Lucaszyf/lx200-smart-front-panel/hardware/pcb/LX200 SMART FRONT PANEL-WITH WI-FI & BLUETOOTH_V1.0-260811-4层.dxf

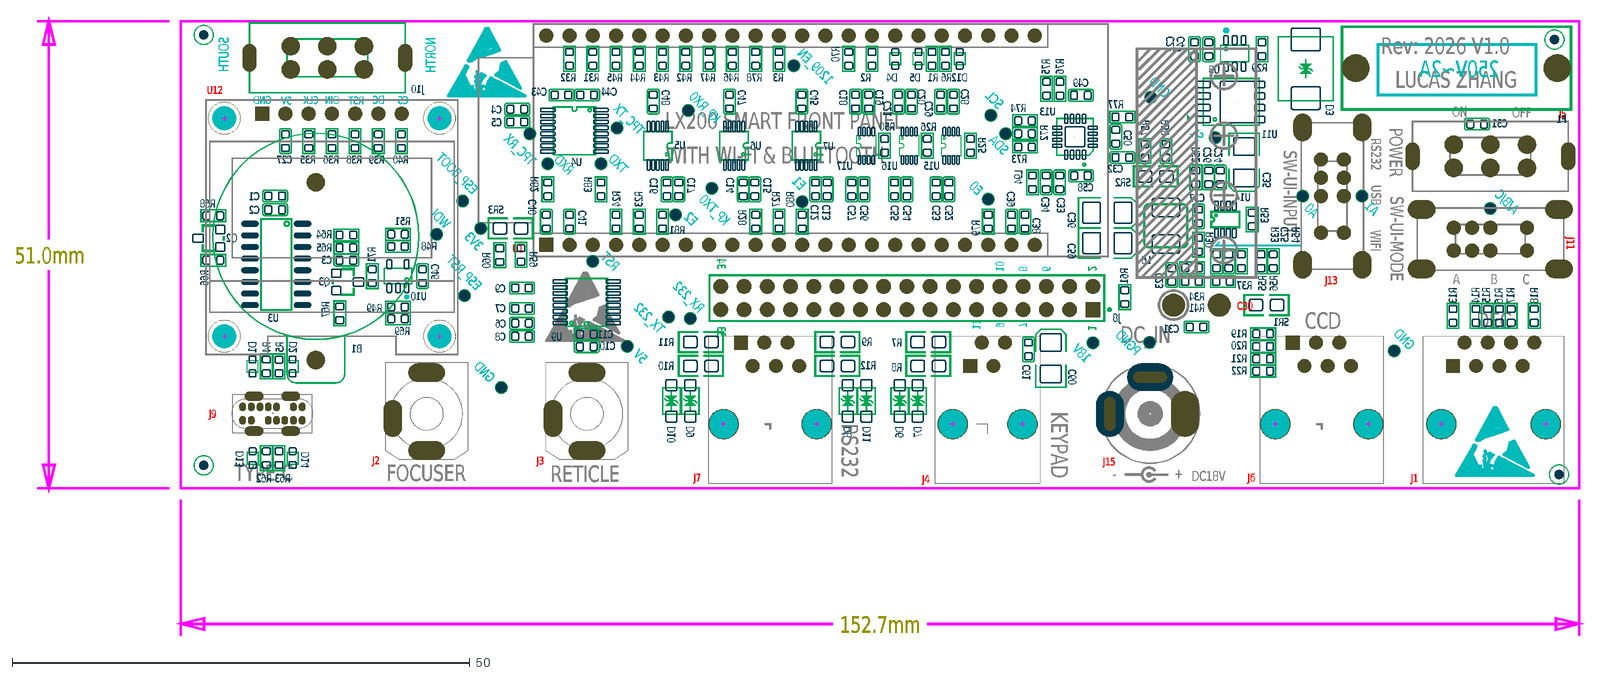
[picture p3: CAD file, 2026-10-14]
hardware/pcb/LX200 SMART FRONT PANEL-WITH WI-FI & BLUETOOTH_V1.0-260811-4层.dxf
152.7mm
51.0mm
-
+
FOCUSER
RETICLE
TYPE-C
RS232
KEYPAD
DC_IN
CCD
DEC
USB
WIFI
OFF
ON
A
B
C
ESP_RST
ESP_BOOT
A0
A1
A/B/C
5V
18V
3V3
PGND
GND
S1
SDA
SCL
NORTH
SOUTH
RXD
TXD
1209_EN
LX200 SMART FRONT PANEL
WITH WI-FI & BLUETOOTH
Rev: 2026 V1.0
LUCAS ZHANG
SW-UI-INPUT
SW-UI-MODE
POWER
250V~2A
DC18V
DC
CS
RST
DIN
CLK
KP_RX0
KP_TX0
E2
E1
E0
RX_232
TX_232
WDI
TPC_RX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
