Lucaszyf/lx200-smart-front-panel/assets/schematic-overview.pdf

D

6 | 5 | 4 | 3 | 2 | 1

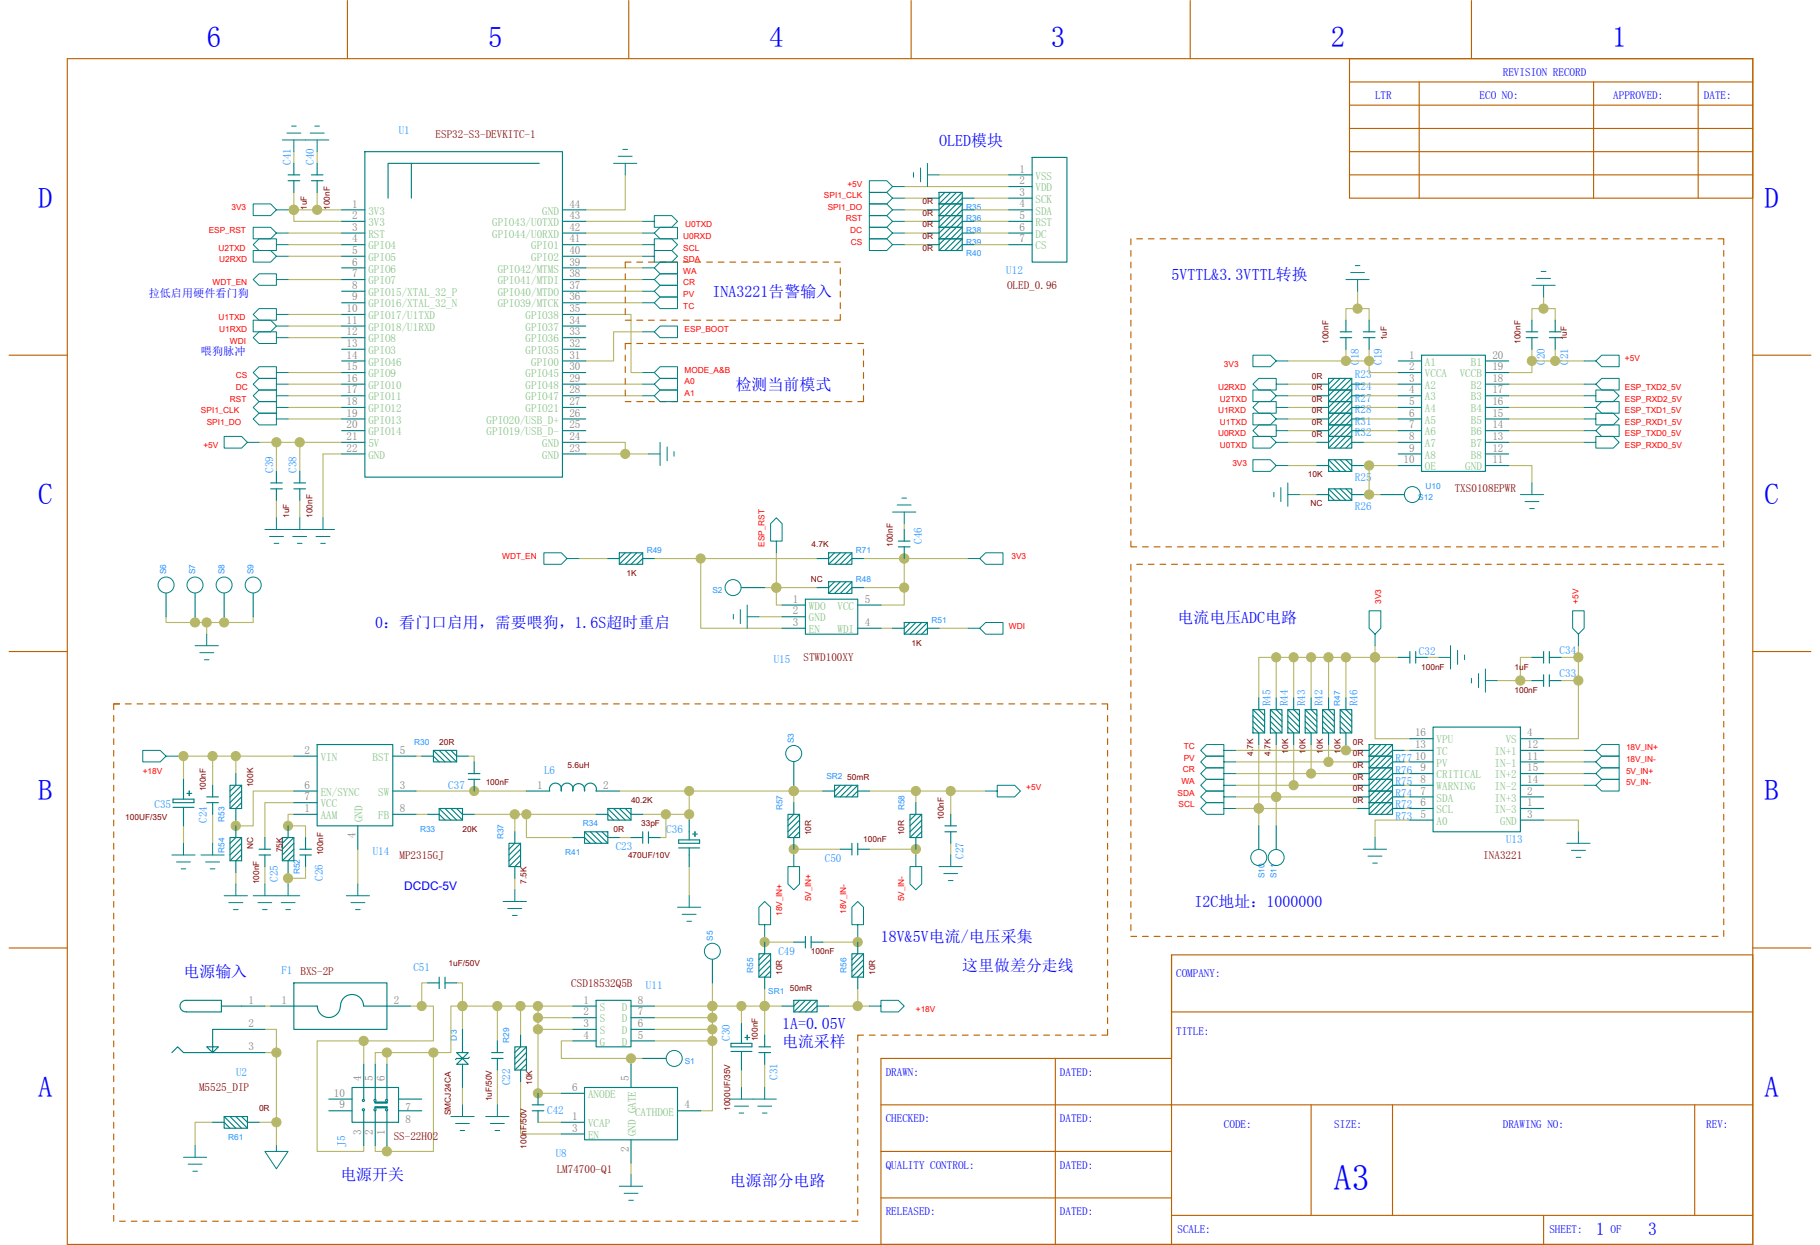
[picture p4: page 1]

CHECKED: | DATED: | CODE: | SIZE: A3 | DRAWING NO: | REV:

QUALITY CONTROL: | DATED:

RELEASED: | DATED:

SCALE: | SHEET: OF

D

6

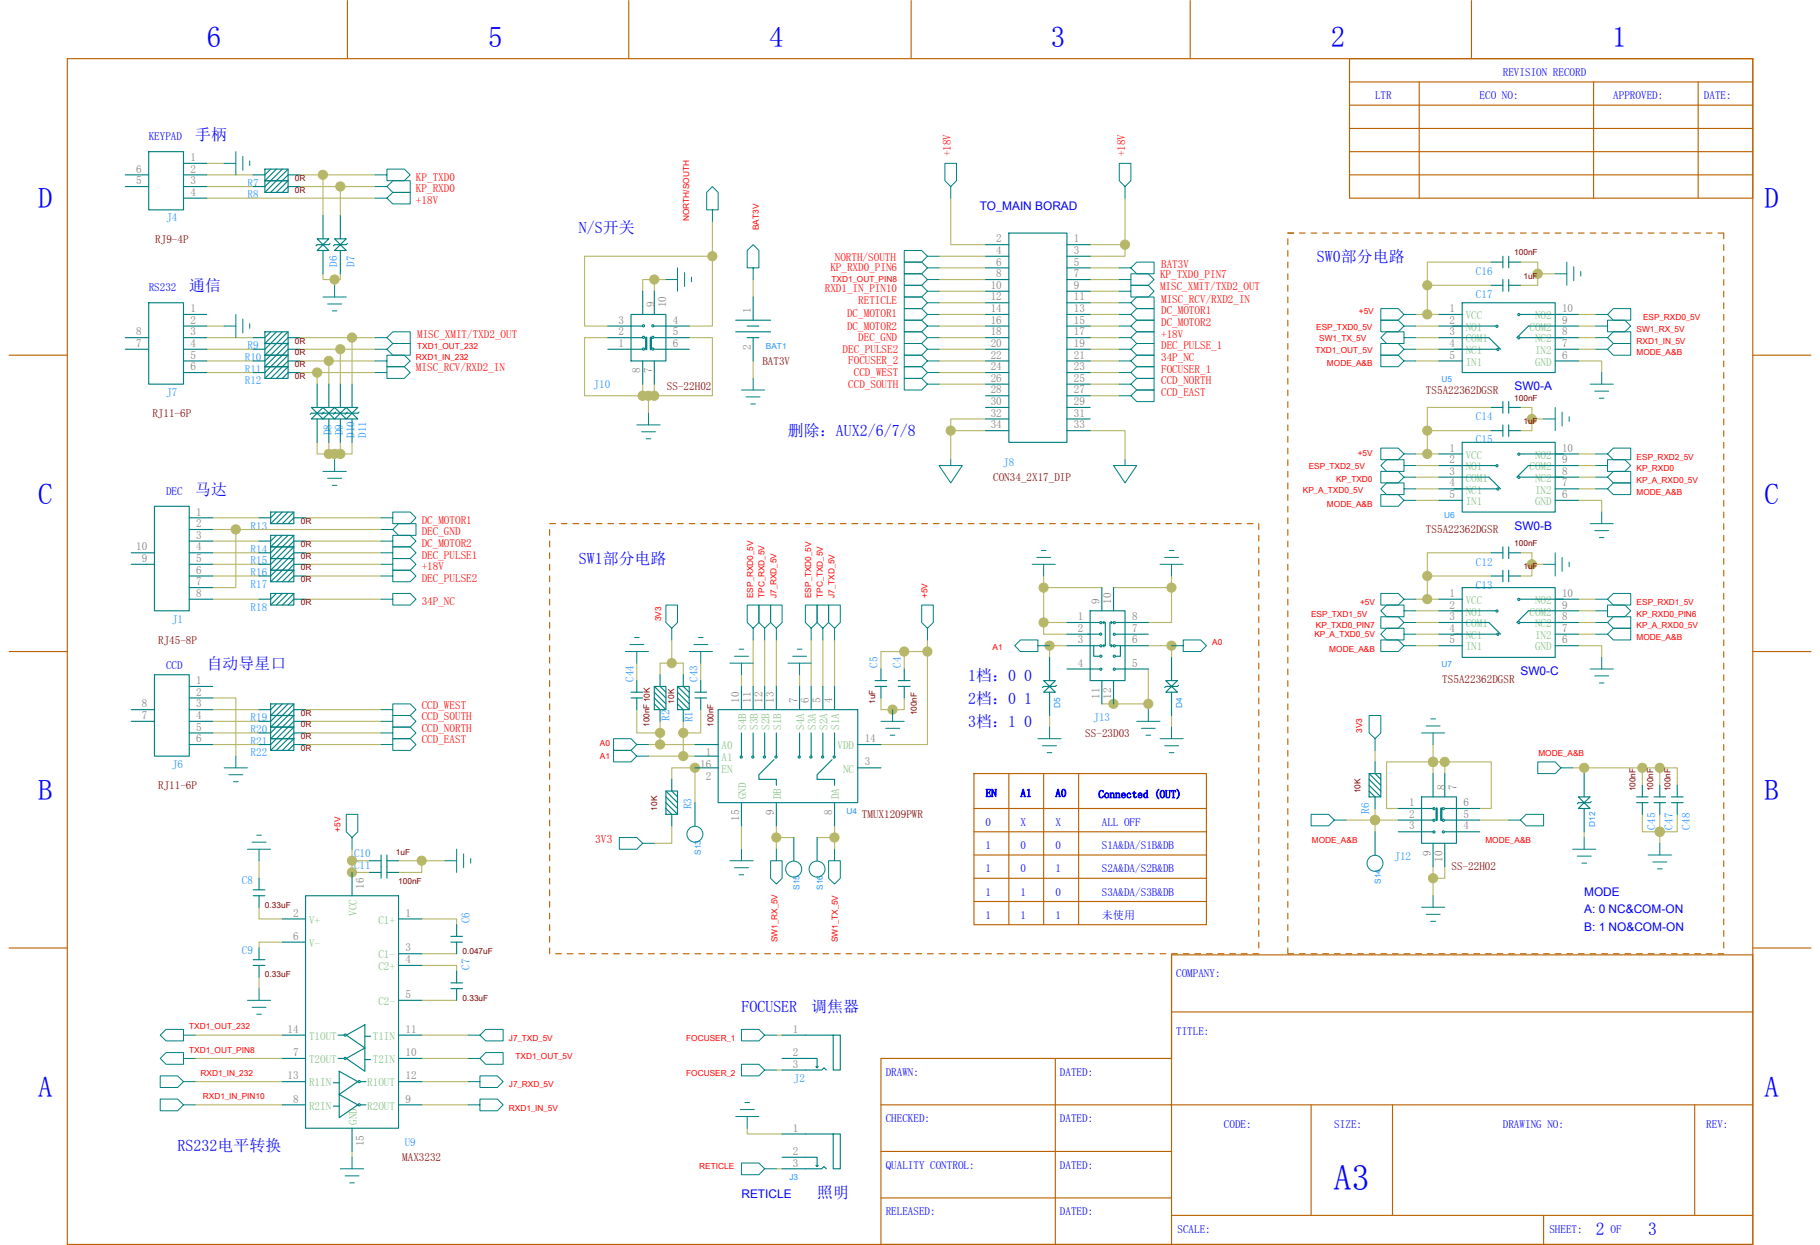
[picture p5: page 2]

D

6 | 5 | 4 | 3 | 2 | 1

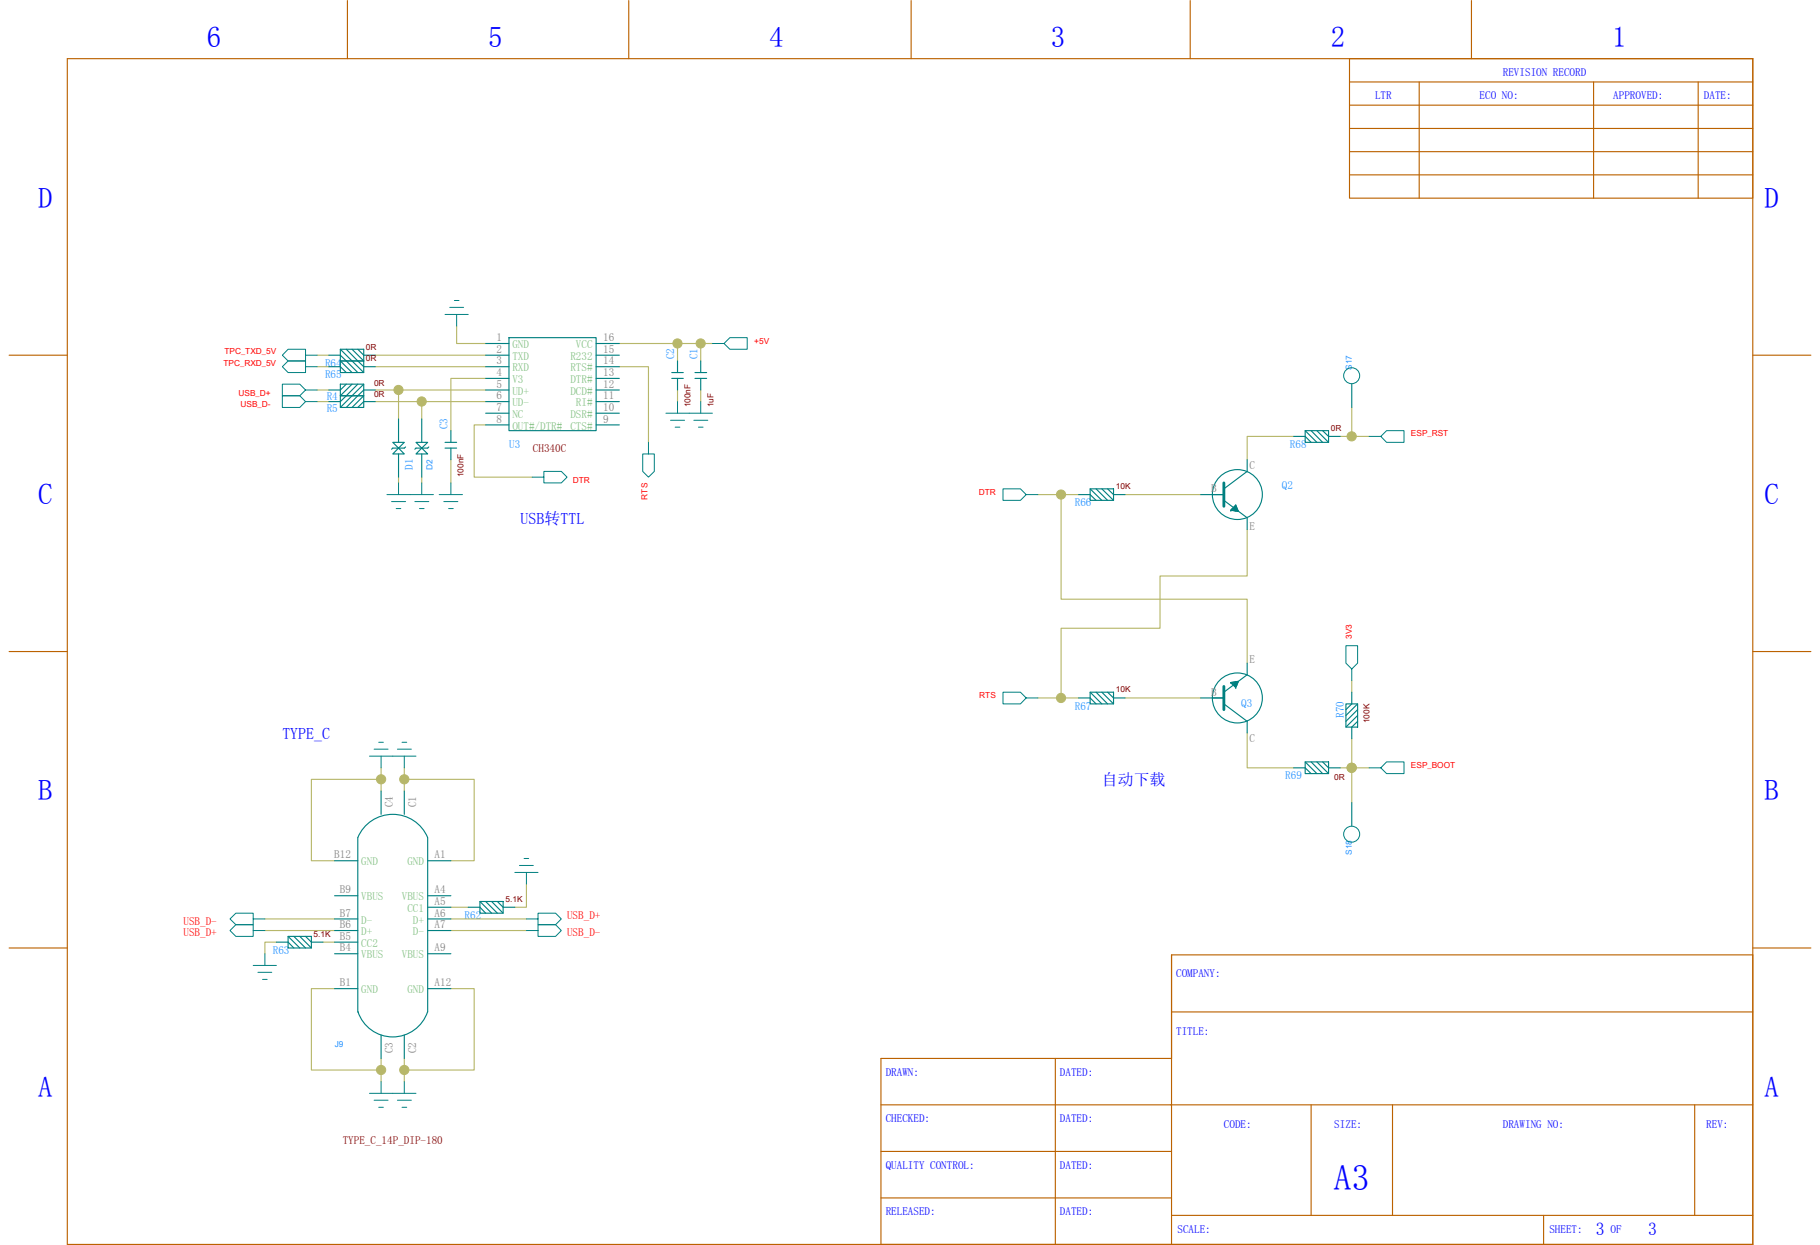
[picture p6: page 3]
