Lucaszyf/lx200-smart-front-panel/hardware/pcb/LX200 SMART FRONT PANEL-WITH WI-FI & BLUETOOTH_V1.0-260810-4层.pdf

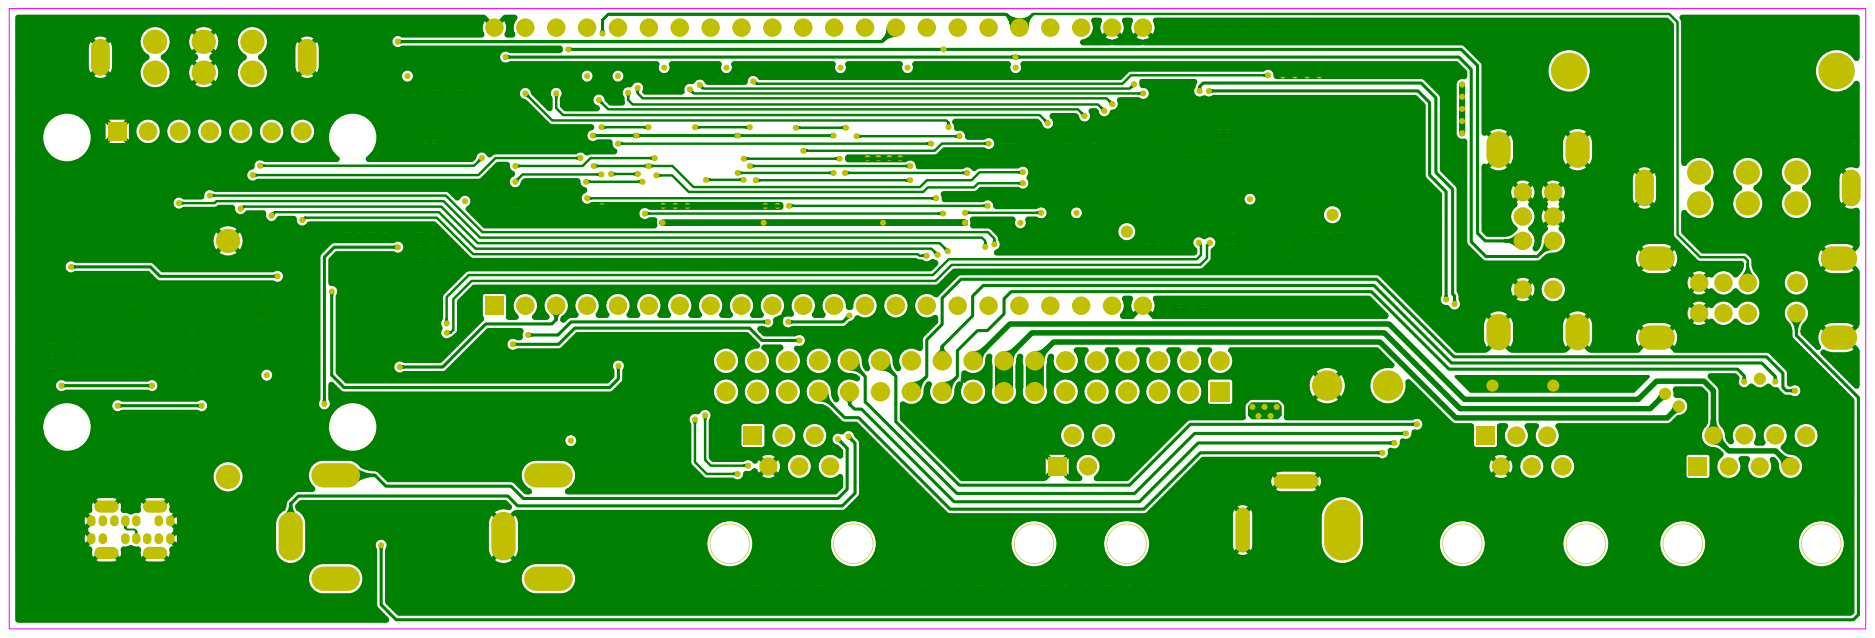
[picture p7: page 1]
U1 U¹x1; U¹x2; U¹x3; U¹x4; U¹x5; U¹x6; U¹x7; U¹x8; U¹x9; U¹x10; U¹x11; U¹x12; U¹x13; U¹x14; U¹x15; U¹x16; U¹x17; U¹x18; U¹x19; U¹x20; U¹x21; J9J9xA¹ J9xA⁴ J9xA⁵ J9xA⁶ J9xA⁷; J9xA⁹ J9xA¹² J9xB¹² J9xB⁹; J9xB⁷ J9xB⁶ J9xB⁵ J9xB⁴ J9xB¹ J9xC¹; J9xC² J9xC⁴; J9xC³; C30 C³⁰x2; C³⁰x1; B1B¹x1 B¹x2

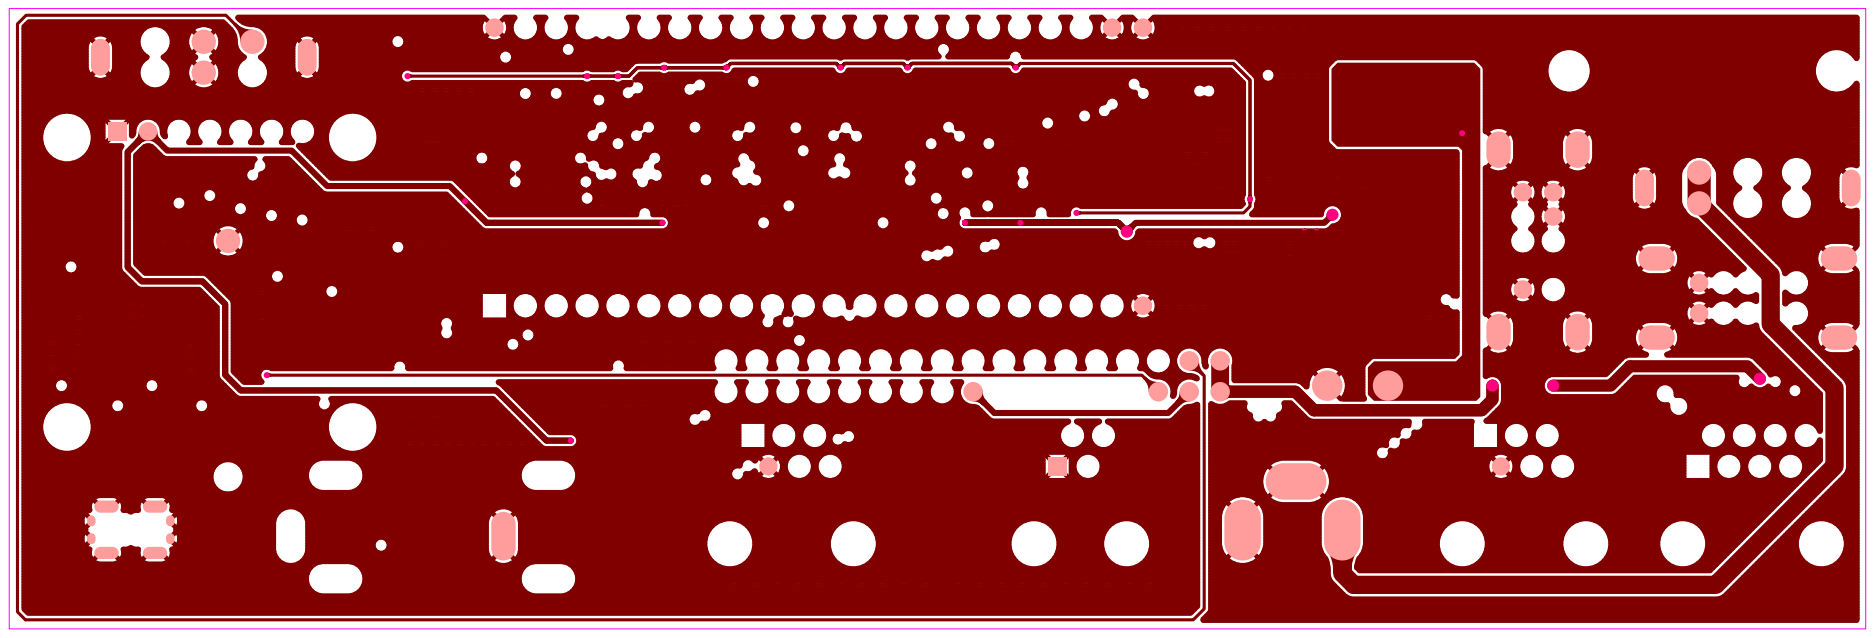
[picture p8: page 2]
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

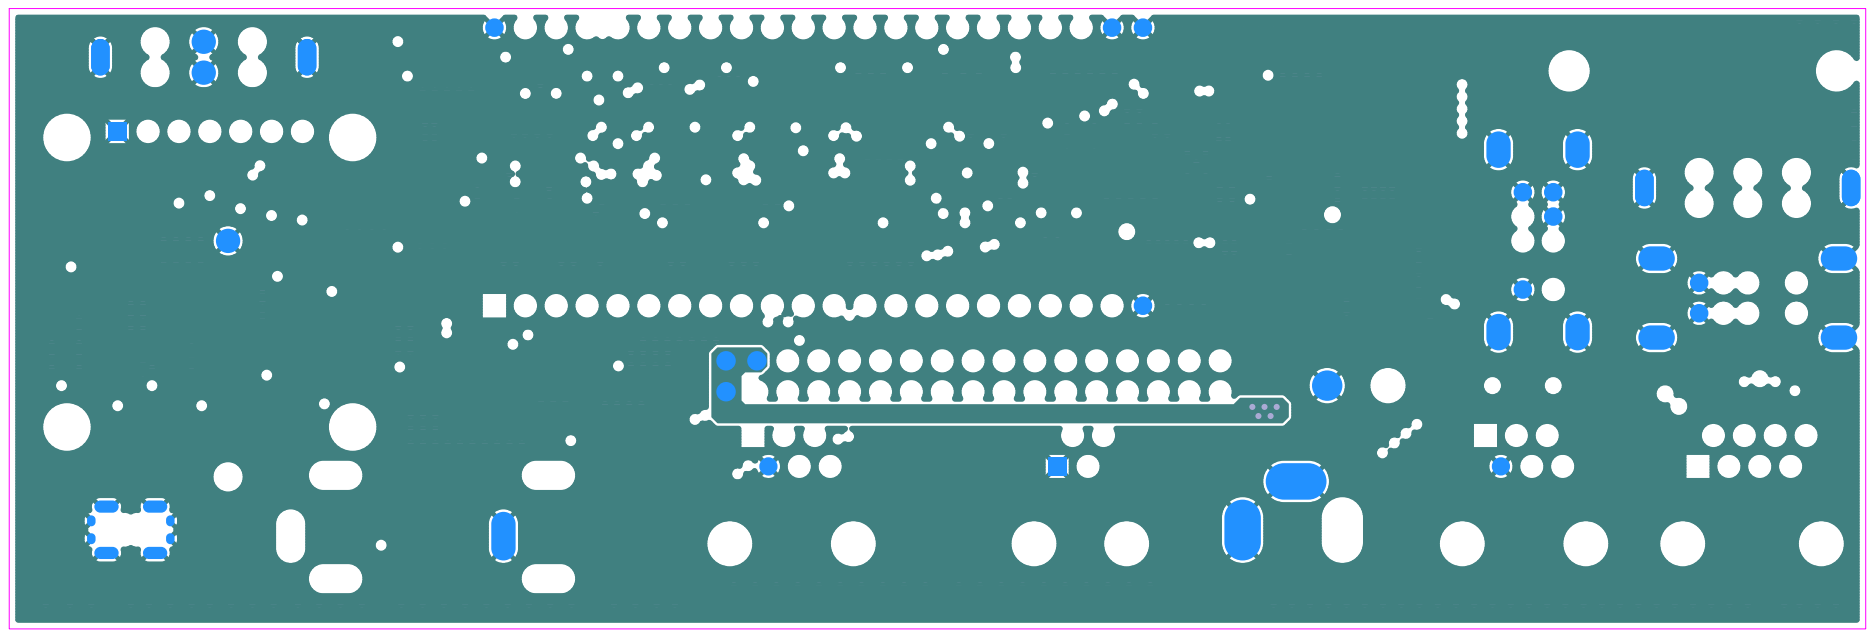
[picture p9: page 3]
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

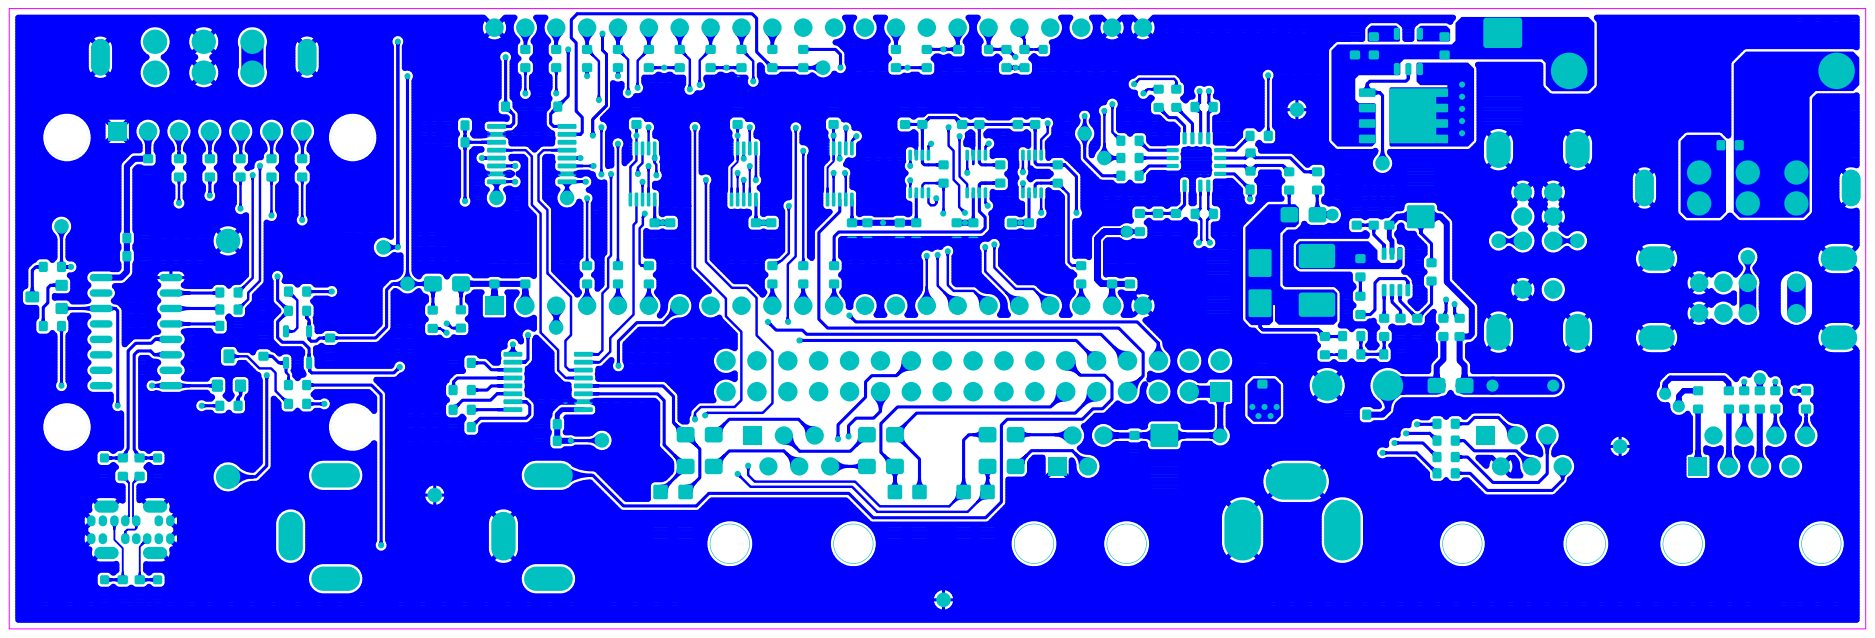
[picture p10: page 4]

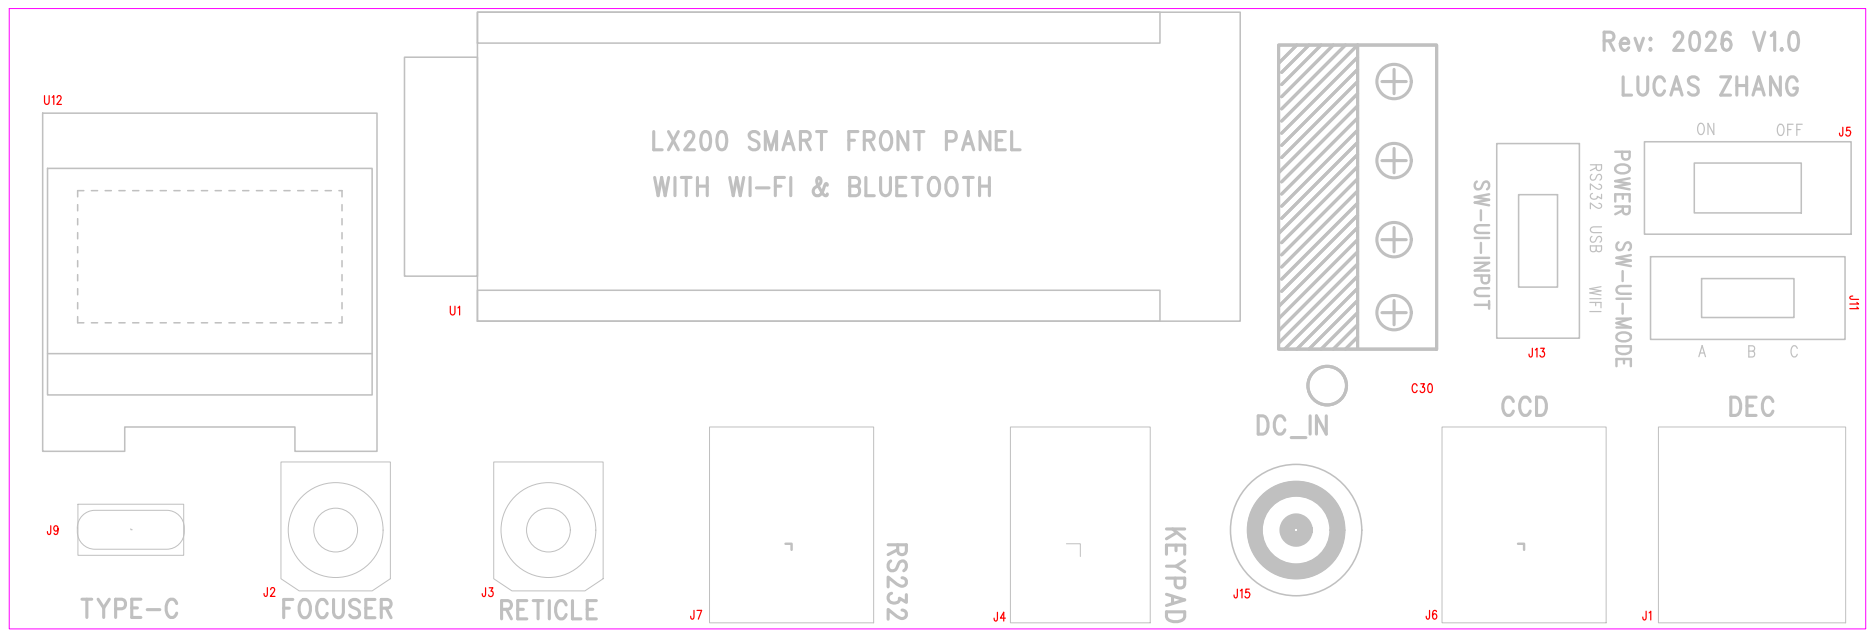
[picture p11: page 5]

LX200 SMART FRONT PANEL
WITH WI-FI & BLUETOOTH

SW-UI-MODE POWER

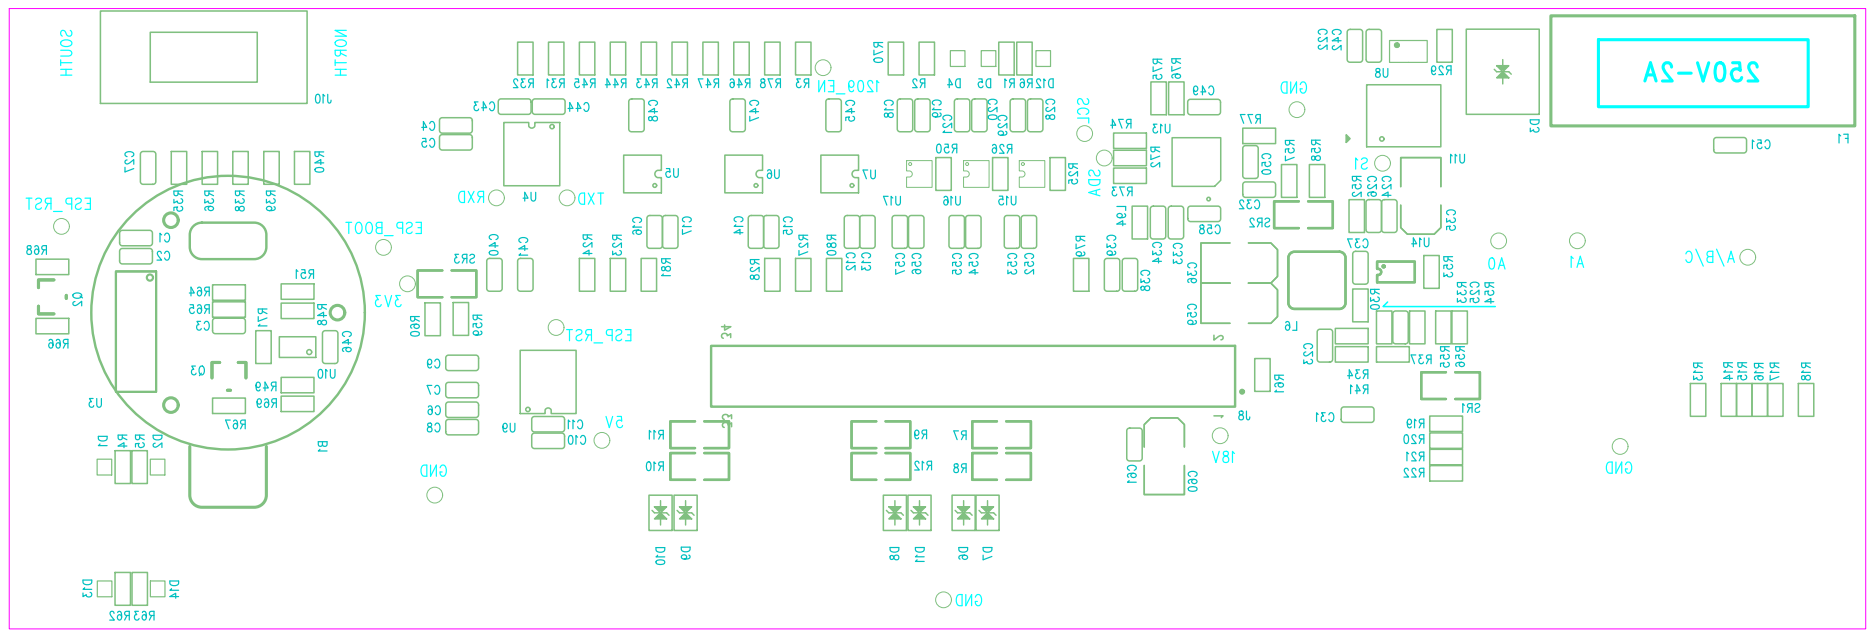
[picture p12: page 6]

J10J10x1 | J10x2 | J10x3 J10x6 | J10x5 | J10x4 J10x79 | J10x810x10
C30 C³⁰x2 | C³⁰x1

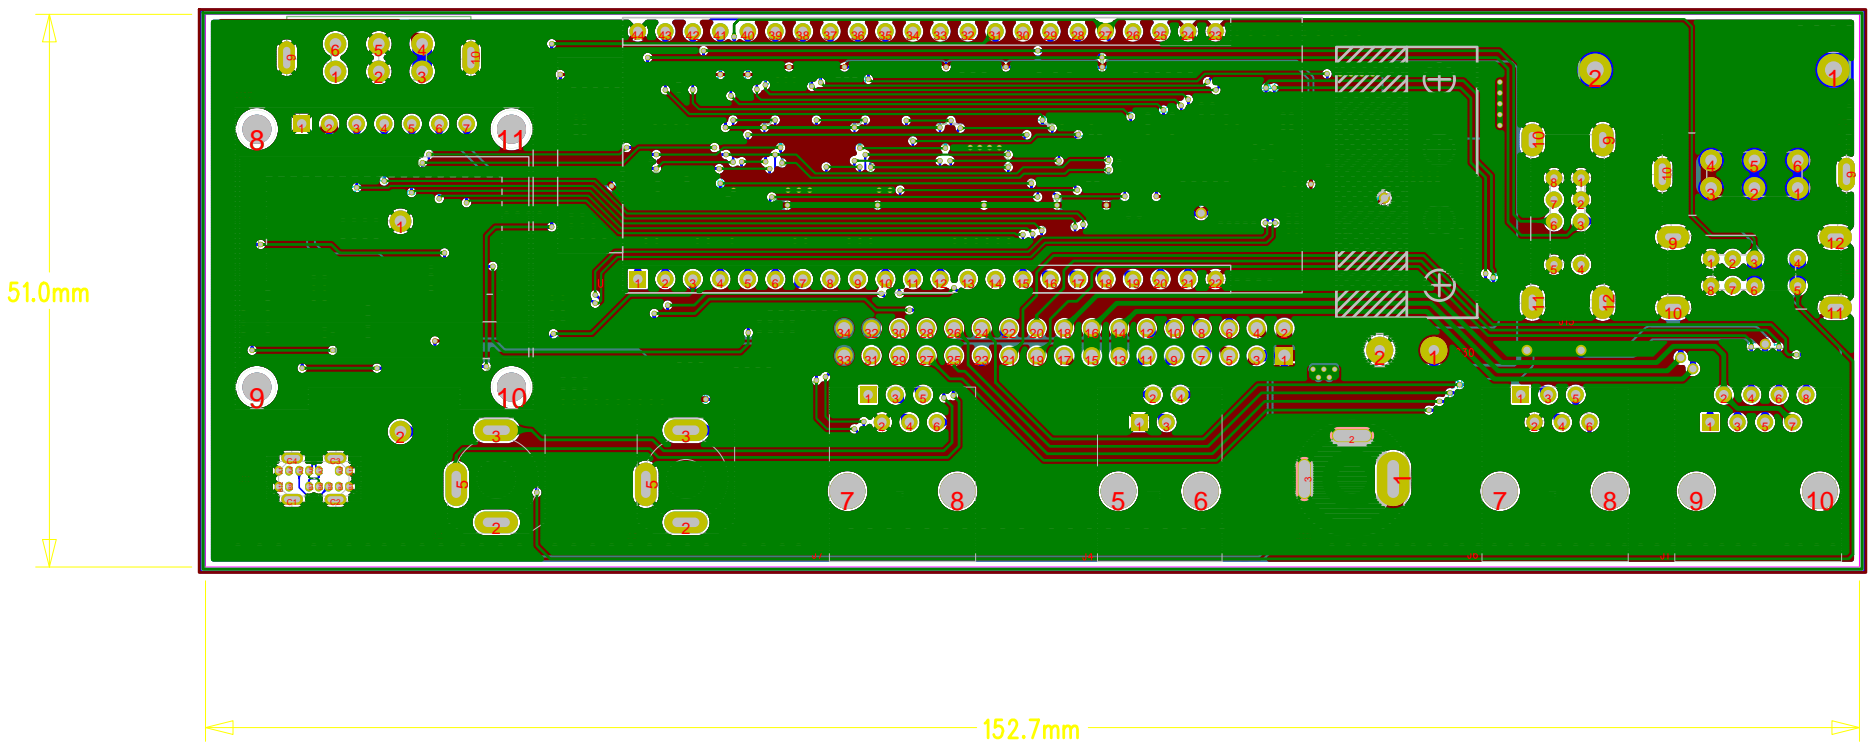
[picture p13: page 7]

WITH WI-FI & BLUETOOTH

SW-UI-MODE POWER
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
