Lucaszyf/lx200-smart-front-panel/firmware/src/mvp6_arduino/oled_font.h

/**
 * oled_font.h — 精简5x7字库（自己设计，非拷贝第三方），仅含MVP0用到的字符
 *
 * 渲染时会做"竖向2倍拉伸"变成14px高（详见 oled_display.cpp 的 double_column()），
 * 原始7px点阵本身不用改。
 *
 * 编码格式：每个字符5个字节，对应5列（从左到右）；每个字节 bit0=该列最上面
 * 一个像素，bit6=该列第7个像素，bit7不使用。
 */

#pragma once

#include <stdint.h>

static const uint8_t k_font5x7[][5] = {
    {0x3E, 0x41, 0x41, 0x41, 0x3E}, // '0'
    {0x00, 0x42, 0x7F, 0x40, 0x00}, // '1'
    {0x42, 0x61, 0x51, 0x49, 0x46}, // '2'
    {0x22, 0x41, 0x49, 0x49, 0x36}, // '3'
    {0x18, 0x14, 0x12, 0x7F, 0x10}, // '4'
    {0x27, 0x45, 0x45, 0x45, 0x39}, // '5'
    {0x3C, 0x4A, 0x49, 0x49, 0x30}, // '6'
    {0x01, 0x71, 0x09, 0x05, 0x03}, // '7'
    {0x36, 0x49, 0x49, 0x49, 0x36}, // '8'
    {0x06, 0x49, 0x49, 0x29, 0x1E}, // '9'
    {0x00, 0x60, 0x60, 0x00, 0x00}, // '.'
    {0x00, 0x36, 0x36, 0x00, 0x00}, // ':'
    {0x08, 0x08, 0x08, 0x08, 0x08}, // '-'
    {0x00, 0x08, 0x14, 0x22, 0x41}, // '<'
    {0x41, 0x22, 0x14, 0x08, 0x00}, // '>'
    {0x00, 0x00, 0x00, 0x00, 0x00}, // ' '
    {0x7C, 0x12, 0x11, 0x12, 0x7C}, // 'A'
    {0x7F, 0x49, 0x49, 0x49, 0x36}, // 'B'
    {0x3E, 0x41, 0x41, 0x41, 0x22}, // 'C'
    {0x7F, 0x49, 0x49, 0x49, 0x41}, // 'E'
    {0x7F, 0x09, 0x09, 0x09, 0x01}, // 'F'
    {0x3E, 0x41, 0x49, 0x49, 0x7A}, // 'G'
    {0x7F, 0x08, 0x08, 0x08, 0x7F}, // 'H'
    {0x00, 0x41, 0x7F, 0x41, 0x00}, // 'I'
    {0x7F, 0x08, 0x14, 0x22, 0x41}, // 'K'
    {0x7F, 0x02, 0x04, 0x02, 0x7F}, // 'M'
    {0x7F, 0x02, 0x04, 0x08, 0x7F}, // 'N'
    {0x3E, 0x41, 0x41, 0x41, 0x3E}, // 'O'
    {0x7F, 0x09, 0x09, 0x09, 0x06}, // 'P'
    {0x7F, 0x09, 0x19, 0x29, 0x46}, // 'R'
    {0x46, 0x49, 0x49, 0x49, 0x31}, // 'S'
    {0x01, 0x01, 0x7F, 0x01, 0x01}, // 'T'
    {0x3F, 0x40, 0x40, 0x40, 0x3F}, // 'U'
    {0x1F, 0x20, 0x40, 0x20, 0x1F}, // 'V'
    {0x7F, 0x20, 0x18, 0x20, 0x7F}, // 'W'
    {0x03, 0x04, 0x78, 0x04, 0x03}, // 'Y'
    {0x00, 0x40, 0x7D, 0x40, 0x00}, // 'i'
    {0x7C, 0x04, 0x38, 0x04, 0x78}, // 'm'
    {0x38, 0x44, 0x44, 0x44, 0x38}, // 'o'
    {0x38, 0x44, 0x44, 0x44, 0x3B}, // 'd'
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
};

#define FONT_GLYPH_WIDTH   5
#define FONT_GLYPH_SPACING 1  // 每个字符右边留1列空白

static inline int font_index_for_char(char c)
{
    switch (c) {
        case '0': return 0;  case '1': return 1;  case '2': return 2;
        case '3': return 3;  case '4': return 4;  case '5': return 5;
        case '6': return 6;  case '7': return 7;  case '8': return 8;
        case '9': return 9;  case '.': return 10; case ':': return 11;
        case '-': return 12; case '<': return 13; case '>': return 14;
        case ' ': return 15; case 'A': return 16; case 'B': return 17;
        case 'C': return 18; case 'E': return 19; case 'F': return 20;
        case 'G': return 21; case 'H': return 22; case 'I': return 23;
        case 'K': return 24; case 'M': return 25; case 'N': return 26;
        case 'O': return 27; case 'P': return 28; case 'R': return 29;
        case 'S': return 30; case 'T': return 31; case 'U': return 32;
        case 'V': return 33; case 'W': return 34; case 'Y': return 35;
        case 'i': return 36; case 'm': return 37;
        case 'o': return 38; case 'd': return 39; case 'e': return 40;
        case 'D': return 41;
        default:  return 15; // 未收录字符按空格处理，不会越界
    }
}
